htl-rankweil/zks_emolab/doku/emLab_Blockschaltbild.pptx

Full Bridge
Motor Driver

Select via Resistor

OUT1

Motor
Screw
Terminal

Connectors

Batt
Screw
Terminal

C

VM

Cap
Bank

VMSW

LED VMSW

Low Power Supply

GNDPWR

OUT2

SWD

Pin Header Expansion

Processing/Sensors

Display

ISP

Power

LDO
3V3

VCC3V3
NRF

LDO
3V3

EN_ATM

PWM

SWVMG

PWM

VDD3V3_NRF

Accelerometer
3Axis

VCC3V3_ATM

LED ATM

Atmega
328

UART

Via
jumper

10 Lines

LED NRF

VCC3V3

Reset

BL54
Ezurio

Reset

I2C_NRF

EN_ATM

External

SWVMG

External

VDD3V3_NRF

I2C_ATM

I2C_NRF

10 Lines

VCC3V3_NRF

VCC3V3_ATM

VM

VMSW

Select via
Solder-Jumper

Select Pin by Pin via Solder-Jumper

Expansion 1 (10x Pin Socket)

OLED Display

Expansion 2 (10x Pin Socket)
