htl-rankweil/zks_emolab/kicad/production/bom.csv

Designator | Footprint | Quantity | Value | LCSC Part #
C10, C11, C14, C6, C7, C8 | 0805 | 6 | 1uF | C52923
C13, C16, C20, C9 | 0805 | 4 | 100n | C1525
C15, C5 | 0805 | 2 | 100nF | C52923
C17, C18, C19, C21, C22, C23 | 0805 | 6 | 47u | C140782
C3 | C_Radial_D6.3mm_H7.0mm_P2.50mm | 1 | 100uF
D1 | D_SOD-123 | 1 | D_Zener
D5 | 0805 | 1 | LED | C130723
D6, D7 | 0805 | 2 | LED | C25503856
J1, J2, J9 | PinHeader_1x03_P2.54mm_Vertical | 3 | Conn_01x03_Pin
J10 | PinHeader_2x03_P2.54mm_Vertical | 1 | Conn_02x03_Odd_Even
J3, J4 | TerminalBlock_Phoenix_MKDS-1,5-2-5.08_1x02_P5.08mm_Horizontal | 2 | Screw_Terminal_01x02
J6 | PinHeader_2x03_P2.54mm_Horizontal | 1 | Conn_02x03_Odd_Even
J7, J8 | PinHeader_1x10_P2.54mm_Vertical | 2 | Conn_01x10_Pin
Q1 | SOT-23 | 1 | Q_NMOS_Depletion_GSD
Q2 | SOT-223 | 1 | Q_PMOS_GDSD
R12, R15, R17, R18, R20, R29, R38 | 0805 | 7 | 10k | C25744
R13, R14, R19, R39 | 0805 | 4 | 1k | C11702
R16 | 1206 | 1 | 10k | C25744
R2 | 0805 | 1 | 0
R21, R22, R23, R36 | 0805 | 4 | 51 | C25125
R24, R25, R30 | 0805 | 3 | 4.7k | C25744
R27, R28, R34, R40 | 0805 | 4 | 51 | C25741
R3 | 0805 | 1 | 1k
R31, R33 | 0805 | 2 | 100k | C25741
R32 | 0805 | 1 | 1k | C25741
R37 | 0805 | 1 | 51 | C25744
R4, R5, R7 | 0805 | 3 | 5.1k | C25905
R6 | TestGnd_Small | 1 | 0
SW1, SW2 | std_tactile_2 | 2 | SW_Push
U1 | SOT-23 | 1 | ~
U10 | QFN-32-1EP_5x5mm_P0.5mm | 1 | ATmega328P-M
U11 | SOIC-8-1EP_3.9x4.9mm_P1.27mm_EP2.29x3mm_ThermalVias | 1 | ~
U2, U3 | SOT-23-5_HandSoldering | 2 | TPS709
U4 | BL54L15U | 1 | BL54L15u
U8 | MC3635_MEM | 1 | MC3635 | C3040827
