htl-rankweil/zks_emolab/kicad/main.kicad_pcb

## KiCad design kicad/main.kicad_pcb (2026-09-08)

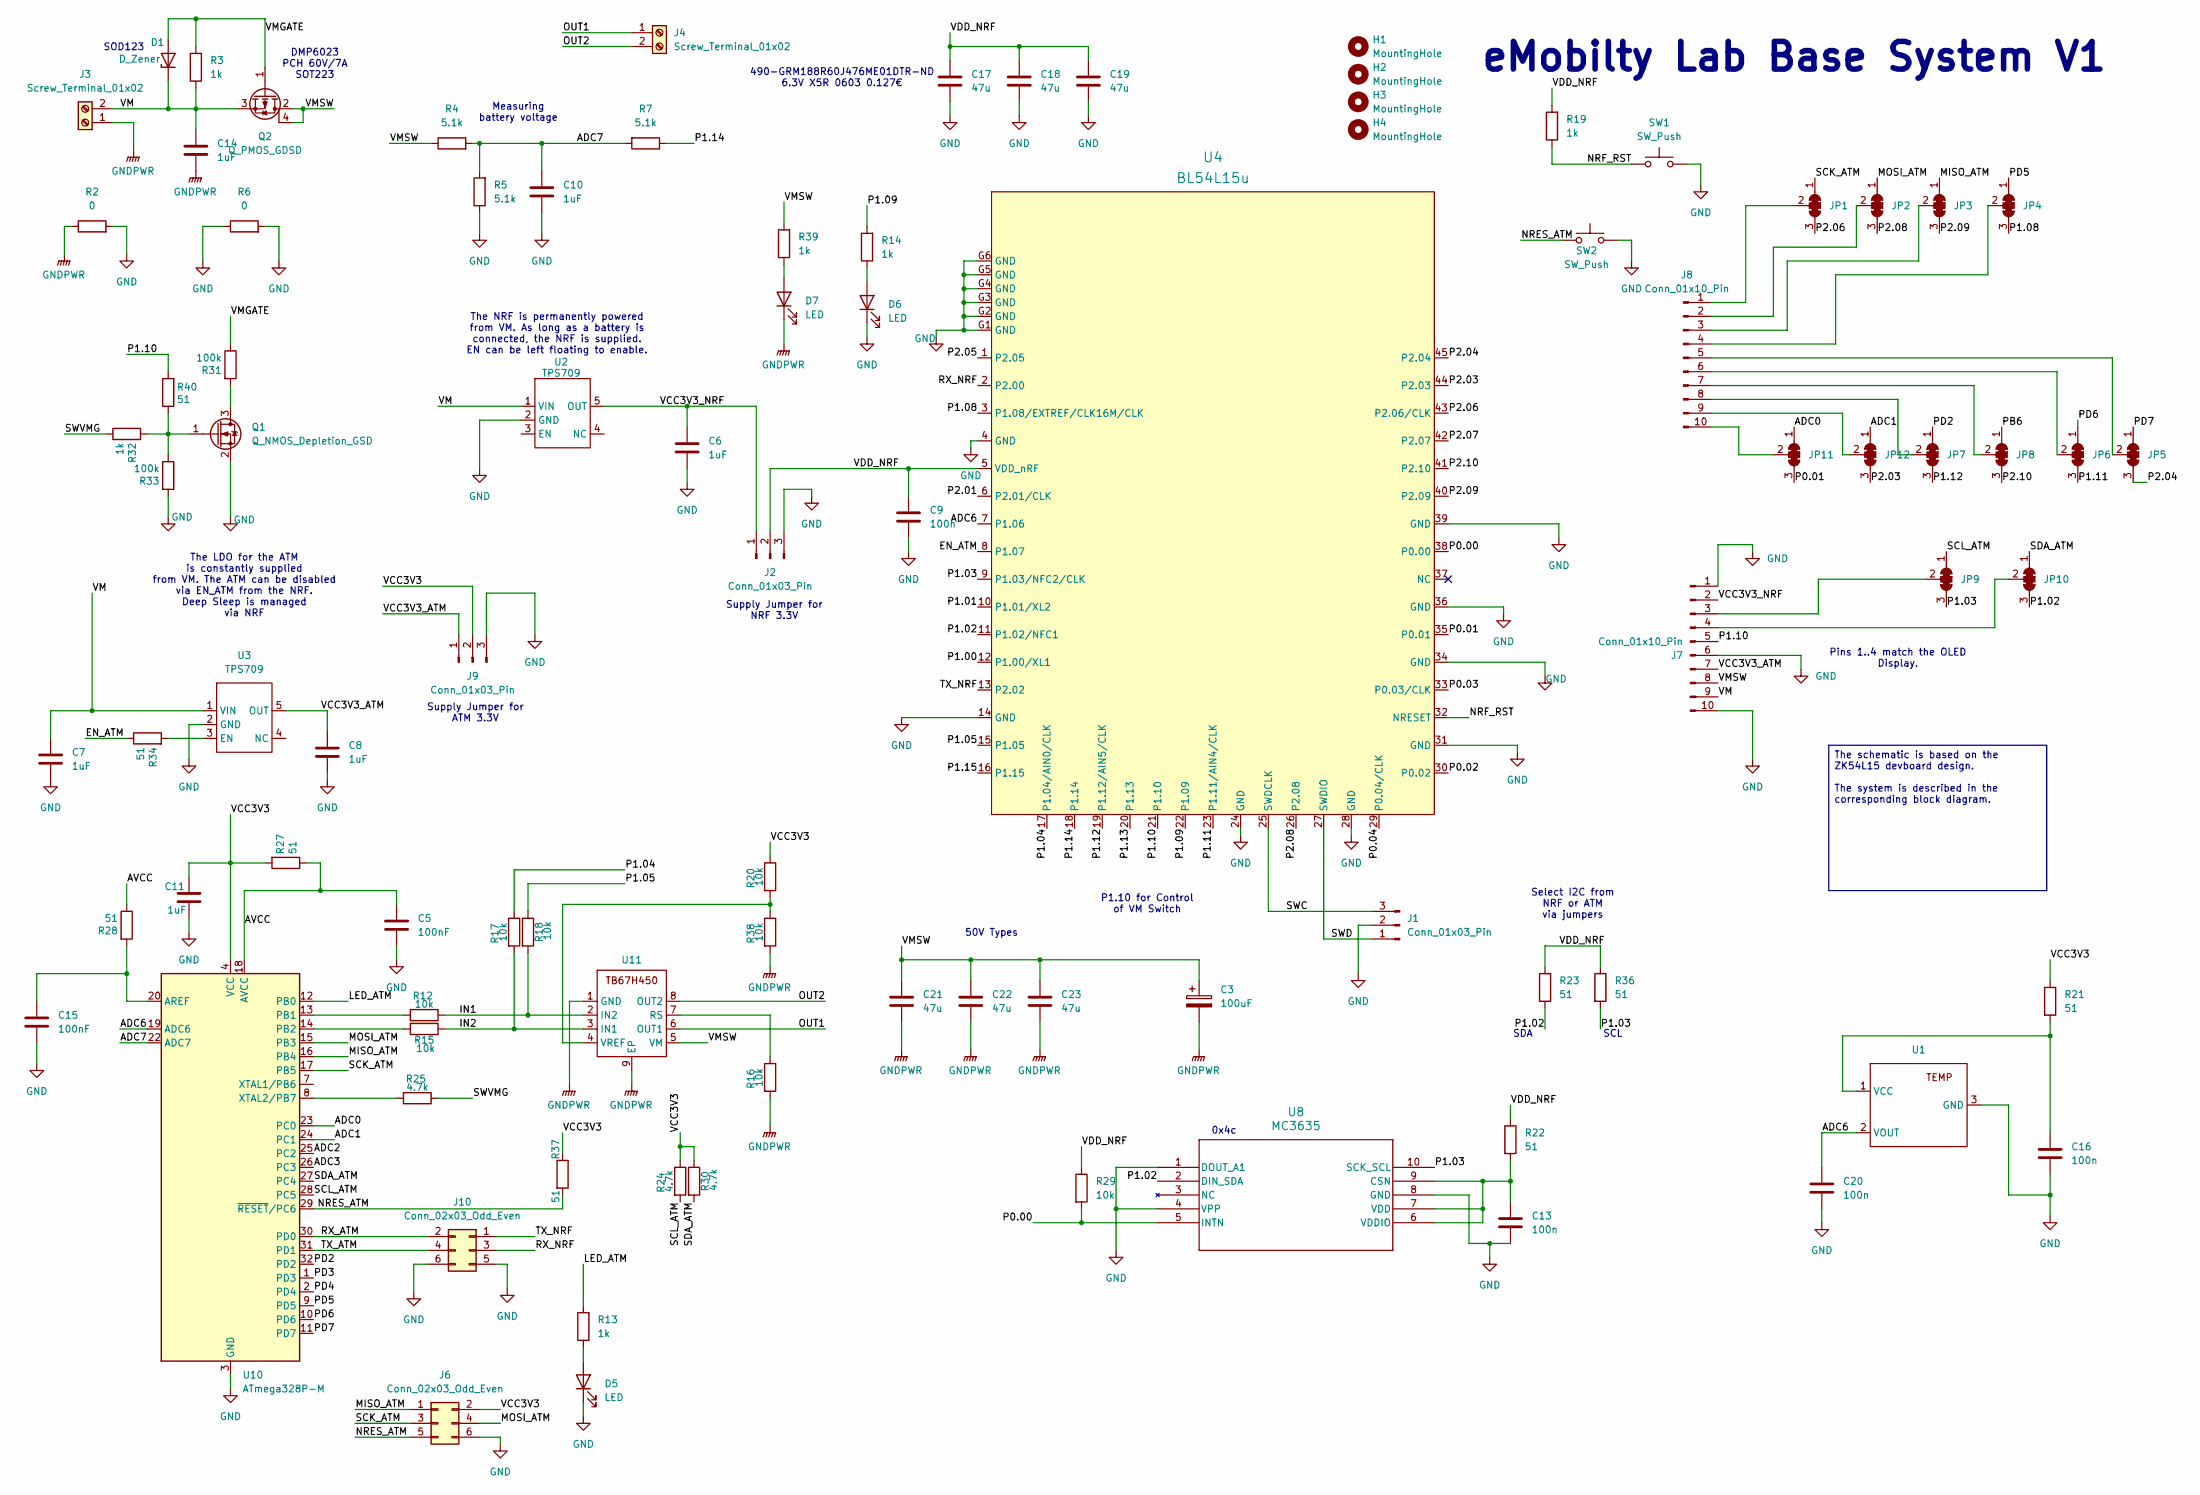
[picture p1: schematic main.kicad_sch, ZK54L15]

Parts:
C3: 100uF; C_Radial_D6.3mm_H7.0mm_P2.50mm
C5, C15: 100nF; C_0805_2012Metric_Pad1.18x1.45mm_HandSolder; LCSC C52923
C6, C7, C8, C10, C11, C14: 1uF; C_0805_2012Metric_Pad1.18x1.45mm_HandSolder; LCSC C52923
C9, C13, C16, C20: 100n; C_0805_2012Metric_Pad1.18x1.45mm_HandSolder; LCSC C1525
C17, C18, C19, C21, C22, C23: 47u; C_0805_2012Metric_Pad1.18x1.45mm_HandSolder; LCSC C140782
D1: D_Zener; D_SOD-123
D5: LED; LED_0805_2012Metric_Pad1.15x1.40mm_HandSolder; LCSC C130723
D6, D7: LED; LED_0805_2012Metric_Pad1.15x1.40mm_HandSolder; LCSC C25503856
H1, H2, H3, H4: MountingHole; MountingHole_2.1mm
J1, J2, J9: Conn_01x03_Pin; PinHeader_1x03_P2.54mm_Vertical
J3, J4: Screw_Terminal_01x02; TerminalBlock_Phoenix_MKDS-1,5-2-5.08_1x02_P5.08mm_Horizont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
J6: Conn_02x03_Odd_Even; PinHeader_2x03_P2.54mm_Horizontal
J7, J8: Conn_01x10_Pin; PinHeader_1x10_P2.54mm_Vertical
J10: Conn_02x03_Odd_Even; PinHeader_2x03_P2.54mm_Vertical
JP1, JP2, JP3, JP4, JP5, JP6, JP7, JP8, JP9, JP10, JP11, JP12: SolderJumper_3_Bridged123; SolderJumper-3_P1.3mm_Bridged123_RoundedPad1.0x1.5mm
Q1: Q_NMOS_Depletion_GSD; SOT-23
Q2: Q_PMOS_GDSD; SOT-223
R2: 0; R_0805_2012Metric_Pad1.20x1.40mm_HandSolder
R3: 1k; R_0805_2012Metric_Pad1.20x1.40mm_HandSolder
R4, R5, R7: 5.1k; R_0805_2012Metric_Pad1.20x1.40mm_HandSolder; LCSC C25905
R6: 0; TestGnd_Small
R12, R15, R17, R18, R20, R29, R38: 10k; R_0805_2012Metric_Pad1.20x1.40mm_HandSolder; LCSC C25744
R13, R14, R19, R39: 1k; R_0805_2012Metric_Pad1.20x1.40mm_HandSolder; LCSC C11702
R16: 10k; R_1206_3216Metric_Pad1.30x1.75mm_HandSolder; LCSC C25744
R21, R22, R23, R36: 51; R_0805_2012Metric_Pad1.20x1.40mm_HandSolder; LCSC C25125
R24, R25, R30: 4.7k; R_0805_2012Metric_Pad1.20x1.40mm_HandSolder; LCSC C25744
R27, R28, R34, R40: 51; R_0805_2012Metric_Pad1.20x1.40mm_HandSolder; LCSC C25741
R31, R33: 100k; R_0805_2012Metric_Pad1.20x1.40mm_HandSolder; LCSC C25741
R32: 1k; R_0805_2012Metric_Pad1.20x1.40mm_HandSolder; LCSC C25741
R37: 51; R_0805_2012Metric_Pad1.20x1.40mm_HandSolder; LCSC C25744
SW1, SW2: SW_Push; std_tactile_2
U1: SOT-23
U2, U3: TPS709; SOT-23-5_HandSoldering
U4: BL54L15u; BL54L15U
U8: MC3635; MC3635_MEM; LCSC C3040827
U10: ATmega328P-M; QFN-32-1EP_5x5mm_P0.5mm
U11: SOIC-8-1EP_3.9x4.9mm_P1.27mm_EP2.29x3mm_ThermalVias

Connections:
/ADC0: JP11.1 (A), U10.23 (PC0)
/ADC1: JP12.1 (A), U10.24 (PC1)
/ADC2: U10.25 (PC2)
/ADC3: U10.26 (PC3)
/ADC6: C20.1, U1.2 (VOUT), U4.7 (P1.06), U10.19 (ADC6)
/ADC7: C10.1, R4.2, R5.2, R7.2, U10.22 (ADC7)
/AVCC: C5.1, R27.1, R28.1, U10.18 (AVCC)
/EN_ATM: R34.1, U4.8 (P1.07)
/IN1: R12.1, R18.2, U11.2 (IN2)
/IN2: R15.1, R17.2, U11.3 (IN1)
/LED_ATM: R13.2, U10.12 (PB0)
/MISO_ATM: J6.1, JP3.1 (A), U10.16 (PB4)
/MOSI_ATM: J6.4, JP2.1 (A), U10.15 (PB3)
/NRES_ATM: J6.5, R37.2, SW2.1, U10.29 (~RESET/PC6)
/NRF_RST: R19.1, SW1.1, U4.32 (NRESET)
/OUT1: J4.1, U11.6 (OUT1)
/OUT2: J4.2, U11.8 (OUT2)
/P0.00: R29.2, U4.38 (P0.00), U8.5 (INTN)
/P0.01: JP11.3 (B), U4.35 (P0.01)
/P0.02: U4.30 (P0.02)
/P0.03: U4.33 (P0.03/CLK)
/P0.04: U4.29 (P0.04/CLK)
/P1.00: U4.12 (P1.00/XL1)
/P1.01: U4.10 (P1.01/XL2)
/P1.02: JP10.3 (B), R23.2, U4.11 (P1.02/NFC1), U8.2 (DIN_SDA)
/P1.03: JP9.3 (B), R36.2, U4.9 (P1.03/NFC2/CLK), U8.10 (SCK_SCL)
/P1.04: R17.1, U4.17 (P1.04/AIN0/CLK)
/P1.05: R18.1, U4.15 (P1.05)
/P1.08: JP4.3 (B), U4.3 (P1.08/EXTREF/CLK16M/CLK)
/P1.09: R14.2, U4.22 (P1.09)
/P1.10: J7.5, R40.2, U4.21 (P1.10)
/P1.11: JP6.3 (B), U4.23 (P1.11/AIN4/CLK)
/P1.12: JP7.3 (B), U4.19 (P1.12/AIN5/CLK)
/P1.13: U4.20 (P1.13)
/P1.14: R7.1, U4.18 (P1.14)
/P1.15: U4.16 (P1.15)
/P2.01: U4.6 (P2.01/CLK)
/P2.03: JP12.3 (B), U4.44 (P2.03)
/P2.04: JP5.3 (B), U4.45 (P2.04)
/P2.05: U4.1 (P2.05)
/P2.06: JP1.3 (B), U4.43 (P2.06/CLK)
/P2.07: U4.42 (P2.07)
/P2.08: JP2.3 (B), U4.26 (P2.08)
/P2.09: JP3.3 (B), U4.40 (P2.09)
/P2.10: JP8.3 (B), U4.41 (P2.10)
/PB6: JP8.1 (A)
/PD2: JP7.1 (A), U10.32 (PD2)
/PD3: U10.1 (PD3)
/PD4: U10.2 (PD4)
/PD5: JP4.1 (A), U10.9 (PD5)
/PD6: JP6.1 (A), U10.10 (PD6)
/PD7: JP5.1 (A), U10.11 (PD7)
/RX_ATM: J10.2, U10.30 (PD0)
/RX_NRF: J10.3, U4.2 (P2.00)
/SCK_ATM: J6.3, JP1.1 (A), U10.17 (PB5)
/SCL_ATM: JP9.1 (A), R24.2, U10.28 (PC5)
/SDA_ATM: JP10.1 (A), R30.2, U10.27 (PC4)
/SWC: J1.3, U4.25 (SWDCLK)
/SWD: J1.1, U4.27 (SWDIO)
/SWVMG: R25.1, R32.1
/TX_ATM: J10.4, U10.31 (PD1)
/TX_NRF: J10.1, U4.13 (P2.02)
/VCC3V3: C11.1, J6.2, J9.2, R20.1, R21.1, R24.1, R27.2, R30.1, R37.1, U10.4 (VCC), U10.6 (VCC)
/VCC3V3_ATM: C8.1, J7.7, J9.1, U3.5 (OUT)
/VCC3V3_NRF: C6.1, J2.1, J7.2, U2.5 (OUT)
/VDD_NRF: C9.1, C17.1, C18.1, C19.1, J2.2, R19.2, R22.1, R23.1, R29.1, R36.1, U4.5 (VDD_nRF)
/VM: C7.1, C14.1, D1.1 (K), J3.2, J7.9, Q2.3 (S), R3.1, U2.1 (VIN), U3.1 (VIN)
/VMGATE: D1.2 (A), Q2.1 (G), R3.2, R31.1
/VMSW: C3.1, C21.1, C22.1, C23.1, J7.8, Q2.2 (D), Q2.4 (D), R4.1, R39.2, U11.5 (VM)
GND: C5.2, C6.2, C7.2, C8.2, C9.2, C10.2, C11.2, C13.2, C15.2, C16.2, C17.2, C18.2, C19.2, C20.2, D5.1 (K), D6.1 (K), J1.2, J2.3, J6.6, J7.1, J7.6, J7.10, J9.3, J10.5, J10.6, Q1.2 (S), R2.2, R5.1, R6.1, R6.2, R33.2, SW1.2, SW2.2, U1.3 (GND), U2.2 (GND), U3.2 (GND), U4.4 (GND), U4.14 (GND), U4.24 (GND), U4.28 (GND), U4.31 (GND), U4.34 (GND), U4.36 (GND), U4.39 (GND), U4.G1 (GND), U4.G2 (GND), U4.G3 (GND), U4.G4 (GND), U4.G5 (GND), U4.G6 (GND), U8.1 (DOUT_A1), U8.4 (VPP), U8.8 (GND), U10.3 (GND), U10.5 (GND), U10.21 (GND)
GNDPWR: C3.2, C14.2, C21.2, C22.2, C23.2, D7.1 (K), J3.1, R2.1, R16.2, R38.2, U11.1 (GND), U11.9 (EP)
unnamed: D5.2 (A), R13.1
unnamed: D6.2 (A), R14.1
unnamed: D7.2 (A), R39.1
unnamed: J7.3, JP9.2 (C)
unnamed: J7.4, JP10.2 (C)
unnamed: J8.1, JP1.2 (C)
unnamed: J8.2, JP2.2 (C)
unnamed: J8.3, JP3.2 (C)
unnamed: J8.4, JP4.2 (C)
unnamed: J8.5, JP5.2 (C)
unnamed: J8.6, JP6.2 (C)
unnamed: J8.7, JP8.2 (C)
unnamed: J8.8, JP7.2 (C)
unnamed: J8.9, JP12.2 (C)
unnamed: J8.10, JP11.2 (C)
unnamed: Q1.3 (D), R31.2
unnamed: Q1.1 (G), R32.2, R33.1, R40.1
unnamed: C16.1, R21.2, U1.1 (VCC)
unnamed: R34.2, U3.3 (EN)
unnamed: C13.1, R22.2, U8.6 (VDDIO), U8.7 (VDD), U8.9 (CSN)
unnamed: C15.1, R28.2, U10.20 (AREF)
unnamed: R12.2, U10.13 (PB1)
unnamed: R15.2, U10.14 (PB2)
unnamed: R25.2, U10.8 (XTAL2/PB7)
unnamed: R16.1, U11.7 (RS)
unnamed: R20.2, R38.1, U11.4 (VREF)

Notes on the sheet:
Supply Jumper for NRF 3.3V
0x4c
SCL
P1.10 for Control of VM Switch
DMP6023 PCH 60V/7A SOT223
Select I2C from NRF or ATM via jumpers
50V Types
Pins 1..4 match the OLED Display.
eMobilty Lab Base System V1
SOD123
490-GRM188R60J476ME01DTR-ND 6.3V X5R 0603 0.127€
Supply Jumper for ATM 3.3V
SDA
The NRF is permanently powered from VM. As long as a battery is connected, the NRF is supplied. EN can be left floating to enable.
Measuring battery voltage
The LDO for the ATM is constantly supplied from VM. The ATM can be disabled via EN_ATM from the NRF. Deep Sleep is managed via NRF
The schematic is based on the ZK54L15 devboard design. The system is described in the corresponding block diagram.

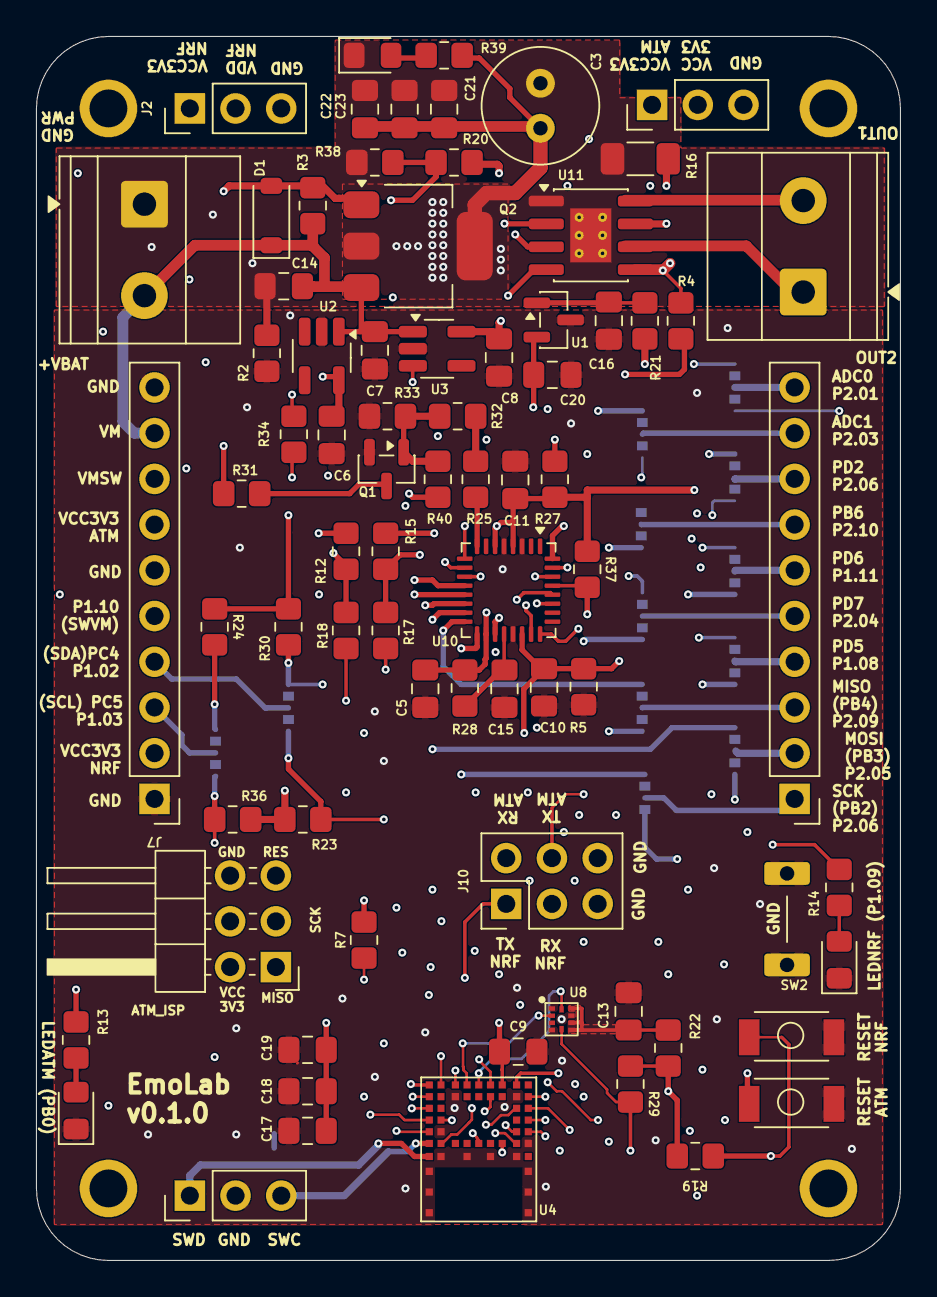
[picture p2: board main.kicad_pcb from above]

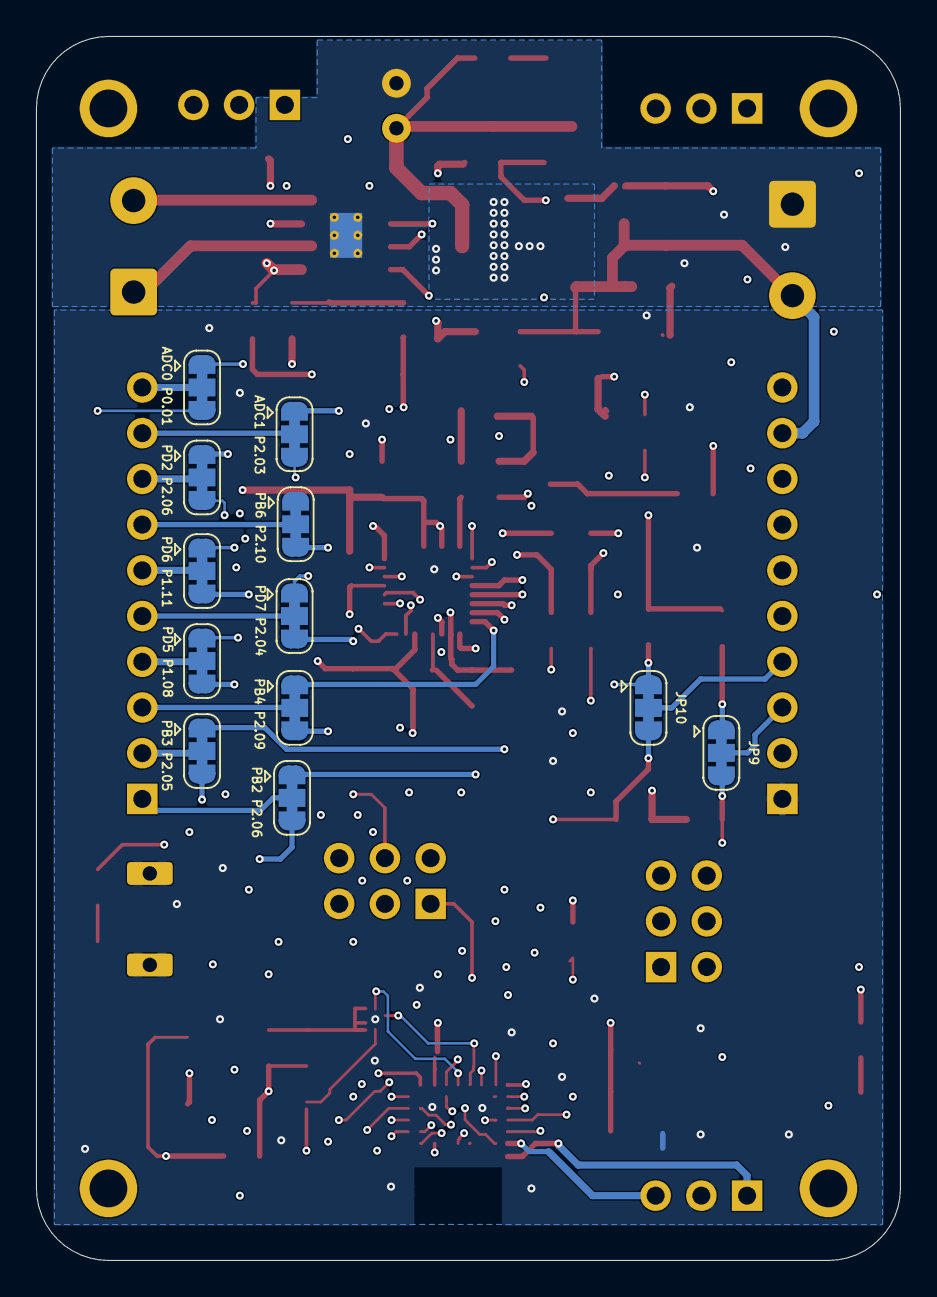
[picture p3: board main.kicad_pcb from below]

Board: 4 copper layers, 48.0 x 68.0 mm, 92 parts (12 on the bottom side), 82 nets.
