htl-rankweil/zks_emolab/(commit log)

2026-09-06 add connector for RX/TX. clean design. export Gerbers
    [bom.csv, designators.csv, main.kicad_pcb, main.kicad_sch, positions.csv]
2026-09-06 update documentation files
    [ConnectionListEmobLab.xlsx]
2026-09-08 correct via sizes after complain from JLC
    [main.kicad_pcb]
2026-10-16 change compionent values
    [main.kicad_sch]
